amisapta15/DPI-adexp-neuron-ttihp/klayout/chip_top_extracted.cir

* Extracted by KLayout with SG13G2 LVS runset on : 20/03/2026 22:08

.SUBCKT chip_top ua[5] ua[1] VDPWR VGND uio_in[1] ua[0] uio_in[0] ua[2] ua[3]
+ ua[4] uo_out[0] ui_in[0] uo_out[1] ui_in[1] uo_out[2] ui_in[2] ui_in[3]
+ uo_out[3] uo_out[4] ui_in[4] ui_in[5] uo_out[5] uo_out[6] ui_in[6] ui_in[7]
+ uo_out[7] uio_out[5] uio_in[2] uio_out[6] uio_in[3] uio_out[7] uio_in[4]
+ uio_oe[4] uio_oe[3] uio_oe[2] uio_oe[1] uio_oe[0] uio_out[4] uio_out[3]
+ uio_out[2] uio_out[1] uio_out[0] uio_oe[7] uio_oe[6] uio_oe[5]
M$1 VGND VGND VGND VGND sg13_lv_nmos L=0.15u W=8u AS=3.92p AD=3.92p PS=23.84u
+ PD=23.84u
M$2 VGND uio_in[1] \$51 VGND sg13_lv_nmos L=0.15u W=1u AS=0.49p AD=0.49p
+ PS=2.98u PD=2.98u
M$5 ua[0] uio_in[1] \$6 VGND sg13_lv_nmos L=0.15u W=8u AS=2.24p AD=2.24p
+ PS=13.48u PD=13.48u
M$15 VGND uio_in[0] \$102 VGND sg13_lv_nmos L=0.15u W=1u AS=0.49p AD=0.49p
+ PS=2.98u PD=2.98u
M$18 ua[0] uio_in[0] \$5 VGND sg13_lv_nmos L=0.15u W=8u AS=2.24p AD=2.24p
+ PS=13.48u PD=13.48u
M$27 VGND \$1806 \$1806 VGND sg13_lv_nmos L=0.13u W=0.3u AS=0.2043375p
+ AD=0.111p PS=1.585u PD=1.34u
M$28 VGND \$1832 \$1807 VGND sg13_lv_nmos L=0.13u W=0.795u AS=0.2043375p
+ AD=0.274275p PS=1.585u PD=2.28u
M$29 VGND \$1808 \$1808 VGND sg13_lv_nmos L=0.13u W=0.3u AS=0.2043375p
+ AD=0.111p PS=1.585u PD=1.34u
M$30 VGND \$1834 \$1809 VGND sg13_lv_nmos L=0.13u W=0.795u AS=0.2043375p
+ AD=0.274275p PS=1.585u PD=2.28u
M$31 VGND \$1810 \$1810 VGND sg13_lv_nmos L=0.13u W=0.3u AS=0.2043375p
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
M$2066 \$687 \$633 \$661 VDPWR sg13_hv_pmos L=2u W=4u AS=0.76p AD=0.76p
+ PS=5.52u PD=5.52u
M$2109 \$846 \$846 \$846 VDPWR sg13_hv_pmos L=1u W=16u AS=3.64p AD=3.64p
+ PS=23.64u PD=23.64u
M$2111 \$846 ua[3] \$777 VDPWR sg13_hv_pmos L=1u W=16u AS=3.04p AD=3.04p
+ PS=19.04u PD=19.04u
M$2113 \$846 ua[5] \$795 VDPWR sg13_hv_pmos L=1u W=16u AS=3.04p AD=3.04p
+ PS=19.04u PD=19.04u
M$2143 VDPWR VDPWR \$777 VDPWR sg13_hv_pmos L=2u W=8u AS=2.12p AD=2.12p
+ PS=16.24u PD=16.24u
M$2144 \$777 ua[2] VGND VDPWR sg13_hv_pmos L=2u W=16u AS=3.04p AD=3.04p
+ PS=22.08u PD=22.08u
M$2146 \$777 \$784 \$784 VDPWR sg13_hv_pmos L=2u W=16u AS=3.04p AD=3.04p
+ PS=22.08u PD=22.08u
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
