amisapta15/DPI-adexp-neuron-ttihp/xschem/simulations/neuron_pulext_tb.spice

** sch_path: /foss/designs/adex_neuron/ttihp26a-adex-neuron-ncs/xschem/neuron_pulext_tb.sch
**.subckt neuron_pulext_tb
Xneuron VDD I_in I_thr I_lk vmem REQ I_adapt I_thrahp CapAdap ACK I_lkahp Iref GND neuron
Ithr VDD I_thr 1p
Ilk VDD I_lk 4p
Iahp I_adapt GND 0n
Iin VDD I_in dc 0 ac 0 pulse(0 Iin_amp 0 20n 20n 1 1)
VDD1 VDD net1 1.2
Iref VDD Iref 200p
Vidd net1 GND 0
.save i(vidd)
Ilkahp VDD I_lkahp 1p
Ithrahp VDD I_thrahp 4p
XM26 I_thr I_thr GND GND sg13_hv_nmos w=1u l=8u ng=2 m=8
XM27 I_lk I_lk GND GND sg13_hv_nmos w=4u l=10u ng=2 m=4
XM15 Iref Iref GND GND sg13_hv_nmos w=4u l=4u ng=2 m=4
XM22 I_adapt I_adapt VDD VDD sg13_hv_pmos w=4u l=4u ng=1 m=4
XM31 I_thrahp I_thrahp GND GND sg13_hv_nmos w=4u l=4u ng=1 m=4
XM32 I_lkahp I_lkahp GND GND sg13_hv_nmos w=4u l=10u ng=2 m=4
Xinv3 VDD Vext net2 GND inv
Xinv4 VDD net2 ACK GND inv
C1 I_thr GND 2p
C2 I_lk GND 2p
C3 Iref GND 2p
C4 I_adapt GND 2p
C5 I_thrahp GND 2p
C6 I_lkahp GND 2p
xext VDD GND Vext REQ pulse_extender
**** begin user architecture code



.param temp=27
.param Iin_amp=200p

.ic V(vmem)=0 V(xneuron.xref.vref)=0 V(REQ)=0 V(ACK)=0 V(CapAdap)=0

.options gmin=1e-13
.control



* ======================================================
*  Iin sweep - measure firing rate of V(REQ) vs Iin
* ======================================================
*  For each DC value of Iin a transient simulation is run.
*  Rising-edge crossings of V(REQ) through a threshold
*  are counted after a settling window and the firing
*  frequency is computed.  Results go to neuron_iin_sweep.raw
* ======================================================

* --- Sweep parameters (Amps) - edit as needed ---
let iin_start = 0
let iin_stop  = 4000e-12
let iin_step  = 200e-12

* --- Compute number of sweep points ---
let num_pts = (iin_stop - iin_start) / iin_step + 1

* --- Create a new plot to hold the accumulated results ---
setplot new
set resplot = $curplot
let iin_values   = unitvec(num_pts)
let firing_rates = unitvec(num_pts)
let sweep_idx = 0
set t_sim = 50m

* --- Main sweep loop ---
dowhile sweep_idx < num_pts

  * Compute cur_iin fresh each iteration to avoid float drift
  let cur_iin = iin_start + sweep_idx * iin_step

  echo
  echo ============================================
  echo   Sweep point: Iin = $&cur_iin A
  echo ============================================

  * Save cur_iin to a shell variable before tran changes the plot context
  set cur_iin_val = $&cur_iin

  * Set the Iin_amp parameter to the current sweep value.
  alterparam Iin_amp = $cur_iin_val
  reset

  save V(REQ)

  * Run transient analysis with adaptive time
  echo   t_sim = $t_sim
  tran 50n $t_sim

  * --- Measure firing frequency using meas tran ---
  * Skip 1st spike (startup glitch), use 2nd-4th spikes
  let t_rise2 = 0
  let t_rise3 = 0
  let t_rise4 = 0
  meas tran t_rise2 WHEN v(REQ)=0.6 RISE=2
  meas tran t_rise3 WHEN v(REQ)=0.6 RISE=3
  meas tran t_rise4 WHEN v(REQ)=0.6 RISE=4
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
