amisapta15/DPI-adexp-neuron-ttihp/(commit log)

2026-02-24 Resolve template merge conflicts
    [project.v]
2026-03-20 Synced with NCS-Neuron final submission to TT-IHP26a
    [ADAP_system.sch, DPI.sch, FB_system.sch, FB_system_bak.sch, Idc.sch, REF_system.sch, V2I.sch, analog_buffer.sch]
2026-05-20 claude adversial review and fix
    [adex_neuron_system_tt_lut32.v]
2026-05-20 Claude Final review bug fix : feat: implement saturating arithmetic and update TauW parameters for AdEx neuron system
    [adex_neuron_system_tt_lut32.v, test.py]
2026-08-13 Implement runtime configuration via SPI in adex_config module
    - Added adex_config.v to handle write-only runtime configuration bank for the baseline network.
    - Integrated SPI mode 0 for configuration updates, allowing shadow writes and atomic commits to active parameters.
    - Updated implementation_plan.md to reflect changes in prime reset and slow-negative periods.
    - Modified project.v to instantiate adex_config and connect it to the network.
    - Adjusted test.py to include tests for SPI shadow and commit functionality, ensuring correct behavior of runtime configuration.
    - Updated Makefile to include adex_config.v in project sources.
    [adex_block.v, adex_config.v, adex_network.v, adex_pair.v, project.v, test.py]
2026-08-13 fix: adjust SPI shift register size and update frame formation logic; update PL_TARGET_DENSITY_PCT in config
    [adex_config.v, project.v]
2026-08-13 fix: update project instance retrieval in test functions for improved hierarchy access
    [test.py]
2026-08-13 feat: add SPI write and commit function; enhance spike collection tests for improved measurement accuracy
